ReclaimerLabs/Dronelight/documentation/39350_Reclaimer_Labs_LLC_16nov17.pdf

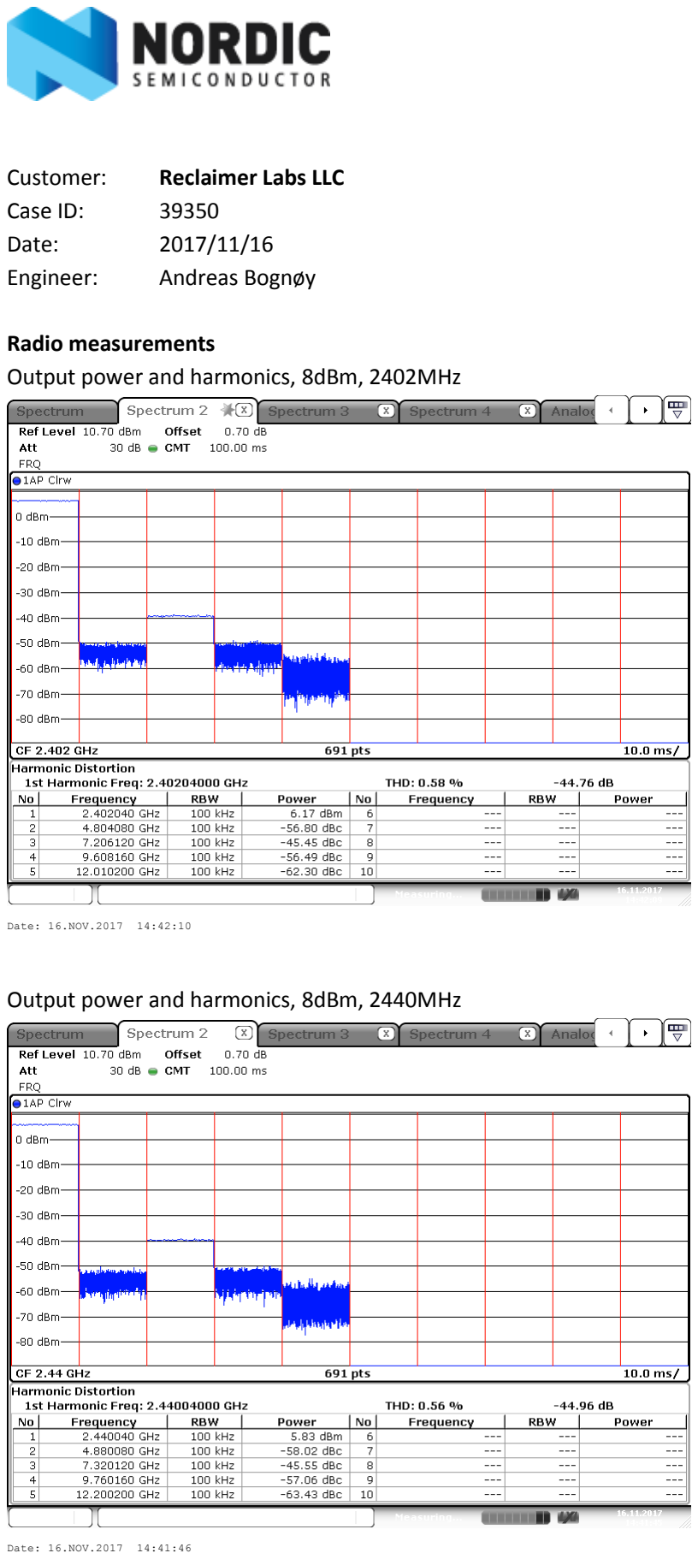
[picture p1: page 1]

Customer: | Reclaimer Labs LLC
Case ID: | 39350
Date: | 2017/11/16
Engineer: | Andreas Bognøy

Radio measurements
Output power and harmonics, 8dBm, 2402MHz

Output power and harmonics, 8dBm, 2440MHz

Date: 16.NOV.2017 | 14:42:10 Date: 16.NOV.2017 | 14:41:46

Output power and harmonics, 8dBm, 2480MHz

Output power and harmonics, 4dBm, 2402MHz

Date: 16.NOV.2017 | 14:42:48 Date: 16.NOV.2017 | 14:43:14

Output power and harmonics, 4dBm, 2440MHz

Output power and harmonics, 4dBm, 2480MHz

Date: 16.NOV.2017 | 14:43:44 Date: 16.NOV.2017 | 14:44:21

RX LO (channel 02-80)

Crystal accuracy

Date: 16.NOV.2017 | 14:48:50 Date: 16.NOV.2017 | 14:47:17

Antenna measurements
Impedance and SWR

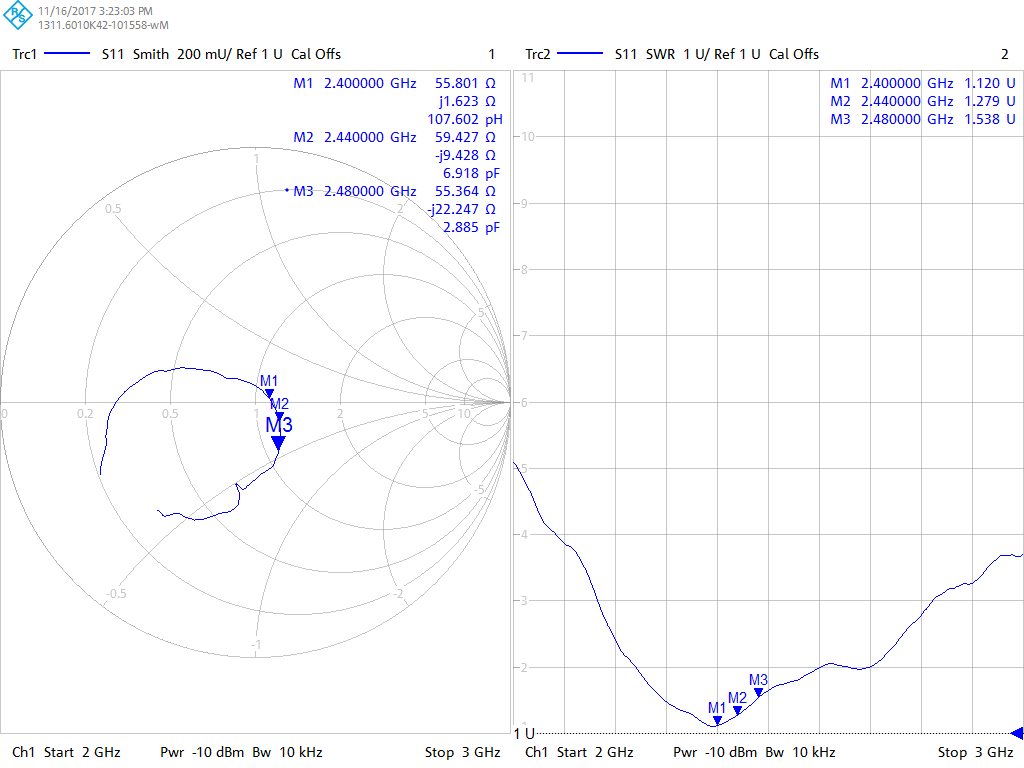
[picture p2: figure]

Cut antenna 1.5 mm
L3 = 0 Ohm/short
C_tune = 0.8 pF

Instruments:

Rohde&Schwarz | FSV13 | Cal date 2016-01 | Spectrum analyzer
Rohde&Schwarz | ZNB8 | Cal date 2016-01 | Vector Network analyzer
Agilent | E3646A | Cal date 2016-01 | Power supply
