ReclaimerLabs/Dronelight/electrical/dronelight_BOM.csv

Reference | Value | Footprint | Datasheet | Manufacturer | Manufacturer Part Number | Supplier 1 | Supplier 1 Part Number | Voltage | DisplayFootprint | TempCo | DNP
D1 | FSV8100V | Reclaimer_Labs:TO-277_3L_Diode |  | Fairchild-ON | FSV8100V | Digikey | FSV8100VCT-ND
L1 | 22uH | Reclaimer_Labs:Inductor_DR127 |  | Eaton | DR127-220-R | Digikey | 513-1044-1-ND
U1 | LT3755-2-MSE | Housings_SSOP:MSOP-16-1EP_3x4mm_Pitch0.5mm |  | Linear | LT3755EMSE-2#PBF | Digikey | LT3755EMSE-2#PBF-ND
Q1 | DMT6016 | Reclaimer_Labs:POWERDI5060-8 |  | Diodes Inc | DMT6016LPS-13
R8 | 0.0005R | Reclaimer_Labs:CST0612 |  | Bourns | CST0612-FC-R0005-E
C7 | 4.7uF | Capacitors_SMD:C_0805 |  | Samsung | CL21A475KOFNNNE
C8 | 1000pF | Capacitors_SMD:C_0603 |  | MacroFab | MF-CAP-0603-1nF
R9 | 28.7k | Resistors_SMD:R_0603 |  | Panasonic | ERJ-3EKF2872V | Digikey | P28.7KHCT-ND
C6 | 0.01uF | Capacitors_SMD:C_0603 |  | MacroFab | MF-CAP-0603-0.01uF
R7 | 100k | Resistors_SMD:R_0603 |  | MacroFab | MF-RES-0603-100K
RT1 | 100k | Resistors_SMD:R_0603 |  | Murata | NCP18WF104J03RB | Digikey | 490-2430-1-ND
R3 | 18k | Resistors_SMD:R_0603 |  | MacroFab | MF-RES-0603-18K
R6 | 100k | Resistors_SMD:R_0603 |  | MacroFab | MF-RES-0603-100K
R1 | 680k | Resistors_SMD:R_0603 |  | MacroFab | MF-RES-0603-680K
C3 | 10uF | Capacitors_SMD:C_1206 |  | Samsung | CL31A106MBHNNNE |  |  | 50V | 1206 | X5R
R10 | 10k | Resistors_SMD:R_0603 |  | MacroFab | MF-RES-0603-10K
R2 | 825k | Resistors_SMD:R_0603 |  | MacroFab | MF-RES-0603-825K
R4 | 39mR | Resistors_SMD:R_0603 |  | Panasonic | ERJ-3BWFR039V
R5 | 15k | Resistors_SMD:R_0603 |  | MacroFab | MF-RES-0603-15K
J2 | SAFETY | Socket_Strips:Socket_Strip_Straight_1x02_Pitch2.54mm |  | MacroFab | MF-CON-2.54mm-01x02
J1 | CONN_01X04 | Reclaimer_Labs:Header_04x01_2.5mm_RA |  | JST | S4B-EH(LF)(SN)
C2 | 10uF | Capacitors_SMD:C_1206 |  | Samsung | CL31A106MBHNNNE |  |  | 50V | 1206 | X5R
C1 | 10uF | Capacitors_SMD:C_1206 |  | Samsung | CL31A106MBHNNNE |  |  | 50V | 1206 | X5R
C4 | 4.7uF | Capacitors_SMD:C_1206 |  | Taiyo Yuden | HMK325BJ475KM-PE |  |  | 100V | 1210 | X5R
C5 | 4.7uF | Capacitors_SMD:C_1206 |  | Taiyo Yuden | HMK325BJ475KM-PE |  |  | 100V | 1210 | X5R
Q2 | DMT6016 | Reclaimer_Labs:POWERDI5060-8 |  | Diodes Inc | DMT6016LPS-13
C29 | 4.7uF | Capacitors_SMD:C_0805 |  | Samsung | CL21A475KOFNNNE
U2 | nrf52840 | Reclaimer_Labs:AQFN73 |  | Nordic | NRF52840-QIAA-T
J3 | ARM_Debug | Reclaimer_Labs:HEADER_SMT_02x05_1.27MM_POL |  | CNC Tech | 3220-10-0300-00
R11 | 100k | Resistors_SMD:R_0603 |  | MacroFab | MF-RES-0603-100K
Y1 | 32MHz | Reclaimer_Labs:Crystal_SMD_2016-4pin_2.0x1.6mm |  | Murata | XRCGB32M000F2P00R0
C12 | 8.2pF | Capacitors_SMD:C_0402 |  | MacroFab | MF-CAP-0402-8.2pF
C13 | 8.2pF | Capacitors_SMD:C_0402 |  | MacroFab | MF-CAP-0402-8.2pF
C10 | 0.8pF | Capacitors_SMD:C_0402 |  | Murata | GRM1555C2AR80BA01D
L2 | 3.3nH | Capacitors_SMD:C_0402 |  | TDK | MLG1005S3N3BT000
C11 | 0.5pF | Capacitors_SMD:C_0402 |  | Murata | GRM1555C1HR50BA01D
D2 | 1N4148 | Diodes_SMD:D_SOD-123 |  | MacroFab | MF-DIO-SOD123-1N4148
C15 | 1uF | Capacitors_SMD:C_0603 |  | MacroFab | MF-CAP-0603-1uF |  |  | 25V | 0603 | X7R
U3 | AP2204 | Reclaimer_Labs:SOT89-3 |  | Diodes Inc | AP2204R-3.3TRG1
C16 | 0.1uF | Capacitors_SMD:C_0402 |  | MacroFab | MF-CAP-0402-0.1uF |  |  |  | 0402
C20 | 1uF | Capacitors_SMD:C_0603 |  | MacroFab | MF-CAP-0603-1uF |  |  |  | 0603
C17 | 0.1uF | Capacitors_SMD:C_0402 |  | MacroFab | MF-CAP-0402-0.1uF |  |  |  | 0402
C18 | 0.1uF | Capacitors_SMD:C_0402 |  | MacroFab | MF-CAP-0402-0.1uF |  |  |  | 0402
C19 | 0.1uF | Capacitors_SMD:C_0402 |  | MacroFab | MF-CAP-0402-0.1uF |  |  |  | 0402
C23 | 0.1uF | Capacitors_SMD:C_0402 |  | MacroFab | MF-CAP-0402-0.1uF |  |  |  | 0402
C26 | 100pF | Capacitors_SMD:C_0402 |  | Murata | GRM1555C1H101JA01D |  |  |  | 0402
C27 | 1uF | Capacitors_SMD:C_0603 |  | MacroFab | MF-CAP-0603-1uF |  |  |  | 0603
C24 | DNP | Capacitors_SMD:C_0402 |  | MacroFab | MF-CAP-0402-0.1uF |  |  |  | 0402 |  | DNP
C25 | DNP | Capacitors_SMD:C_0402 |  | MacroFab | MF-CAP-0402-0.1uF |  |  |  | 0402 |  | DNP
A1 | Antenna | Reclaimer_Labs:2450AT18B100E |  | Johanson | 2450AT18B100E
L3 | 3.3nH | Capacitors_SMD:C_0402 |  | TDK | MLG1005S3N3BT000
C9 | 1.2pF | Capacitors_SMD:C_0402 |  | Johanson | 500R07S1R2BV4T
L4 | 2.7nH | Capacitors_SMD:C_0402 |  | Johanson | L-07C2N7SV6T
J6 | CONN_01X06 | Socket_Strips:Socket_Strip_Straight_1x06_Pitch2.54mm |  | MacroFab | MF-CON-2.54mm-01x06
C21 | 4.7uF | Capacitors_SMD:C_0805 |  | Samsung | CL21A475KOFNNNE |  |  |  | 0805
C14 | 4.7uF | Capacitors_SMD:C_0805 |  | Samsung | CL21A475KOFNNNE |  |  |  | 0805
C22 | 4.7uF | Capacitors_SMD:C_0805 |  | Samsung | CL21A475KOFNNNE |  |  |  | 0805
RT2 | 100k | Resistors_SMD:R_0603 |  | Murata | NCP18WF104J03RB | Digikey | 490-2430-1-ND
R15 | 18k | Resistors_SMD:R_0603 |  | MacroFab | MF-RES-0603-18K
R16 | 750k | Resistors_SMD:R_0603 |  | MacroFab | MF-RES-0603-750K
R17 | 100k | Resistors_SMD:R_0603 |  | MacroFab | MF-RES-0603-100K
J7 | CONN_02X06 | Socket_Strips:Socket_Strip_Straight_2x06_Pitch2.54mm
C28 | DNP | Capacitors_SMD:C_0603 |  | MacroFab | MF-CAP-0603-1uF |  |  |  | 0603 |  | DNP
J4 | XT30 | Reclaimer_Labs:XT30
J5 | USB_OTG | Reclaimer_Labs:USB_Micro-B_10118194-0001LF |  | MacroFab | MF-CON-MICROUSB-RIGHT
X1 | MTHOLE | Reclaimer_Labs:MountingHole_3.5mm_Pad_Via
R12 | 1k | Resistors_SMD:R_0603 |  | MacroFab | MF-RES-0603-1K
D3 | RGB LED 3228 SMD PLCC-4 | Reclaimer_Labs:PLCC4 |  | MacroFab | MF-LED-3228-RGB
R13 | 1k | Resistors_SMD:R_0603 |  | MacroFab | MF-RES-0603-1K
R14 | 1k | Resistors_SMD:R_0603 |  | MacroFab | MF-RES-0603-1K
X2 | MTHOLE | Reclaimer_Labs:MountingHole_3.5mm_Pad_Via
X3 | MTHOLE | Reclaimer_Labs:MountingHole_3.5mm_Pad_Via
X4 | MTHOLE | Reclaimer_Labs:MountingHole_3.5mm_Pad_Via
X5 | HEATSINK | Reclaimer_Labs:573100D00010G |  | Aavid Thermalloy | 573100D00010G
X6 | HEATSINK | Reclaimer_Labs:573100D00010G |  | Aavid Thermalloy | 573100D00010G
X7 | HEATSINK | Reclaimer_Labs:573100D00010G |  | Aavid Thermalloy | 573100D00010G
Q3 | Photo_Trans | Reclaimer_Labs:Photo_Trans_ALS-PT19-315C |  | Everlight | ALS-PT19-315C/L177/TR8
R18 | 10k | Resistors_SMD:R_0603 |  | MacroFab | MF-RES-0603-10K
U5 | LPS22HB | Reclaimer_Labs:LGA10R50P2X3_200X200X80 |  | ST | LPS22HBTR
C30 | 0.1uF | Capacitors_SMD:C_0402 |  | MacroFab | MF-CAP-0402-0.1uF |  |  |  | 0402
U4 | SPK0415HM4H-B | Reclaimer_Labs:SPK0415HM4H-8 |  | Knowles | SPK0415HM4H-B-7
C31 | 0.1uF | Capacitors_SMD:C_0402 |  | MacroFab | MF-CAP-0402-0.1uF |  |  |  | 0402
