ReclaimerLabs/Dronelight/electrical/dronelight_Rev2_schematic.pdf

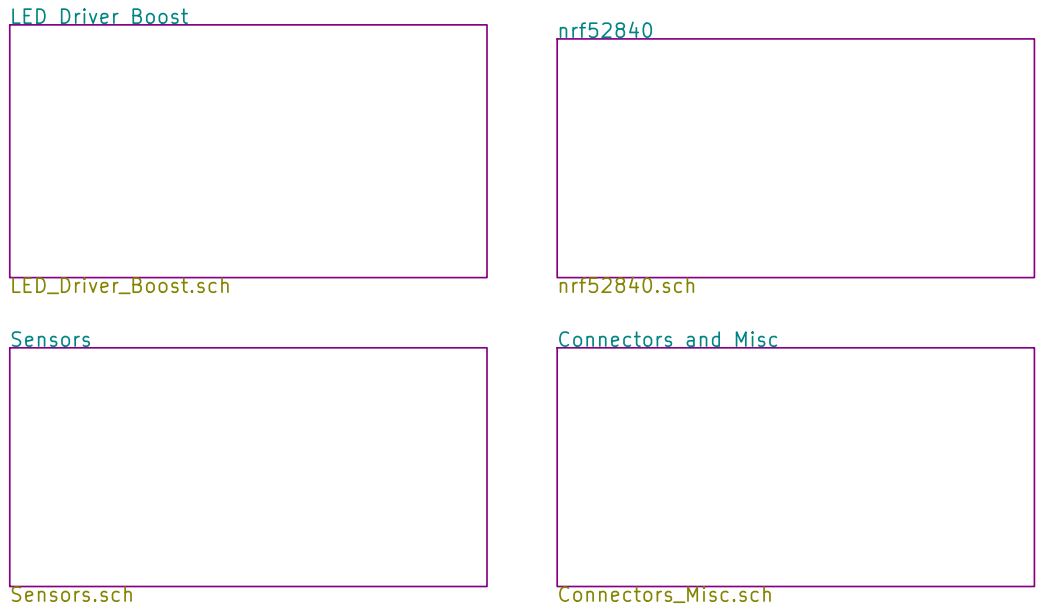
[picture p3: page 1]

LED Driver Boost LED_Driver_Boost.sch

nrf52840.sch Connectors and Misc Connectors_Misc.sch Sensors Sensors.sch

File: dronelight.sch Sheet: / Reclaimer Labs LLC

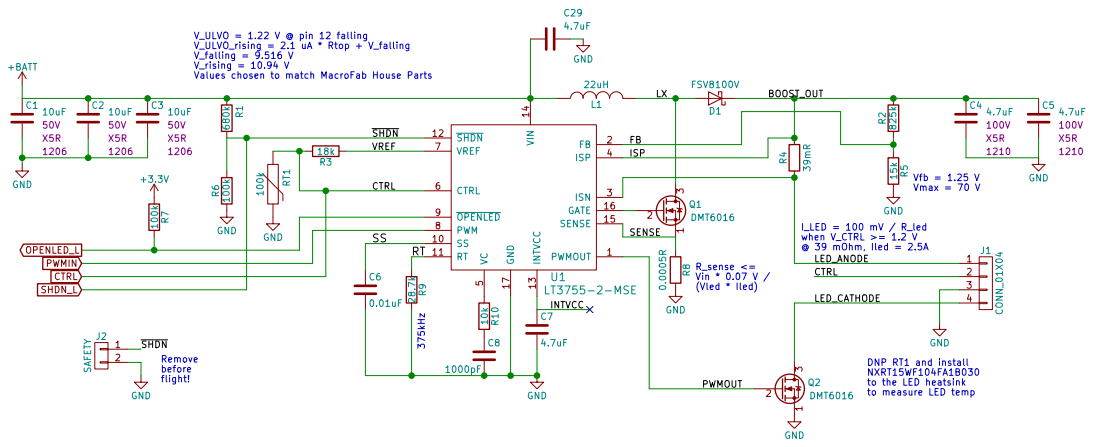
[picture p4: page 2]

5 CTRL 6 VREF 7 PWM 8 OPENLED 9 SS 10 RT 11 SHDN 12 INTVCC 13 VIN 14 SENSE 15 GATE 16 GND 17U1

3 Q1DMT6016 R8 0.0005R GND GND GND GND

DNP RT1 and install NXRT15WF104FA1B030
to the LED heatsink
to measure LED temp

File: LED_Driver_Boost.sch Sheet: /LED Driver Boost/ Reclaimer Labs LLC

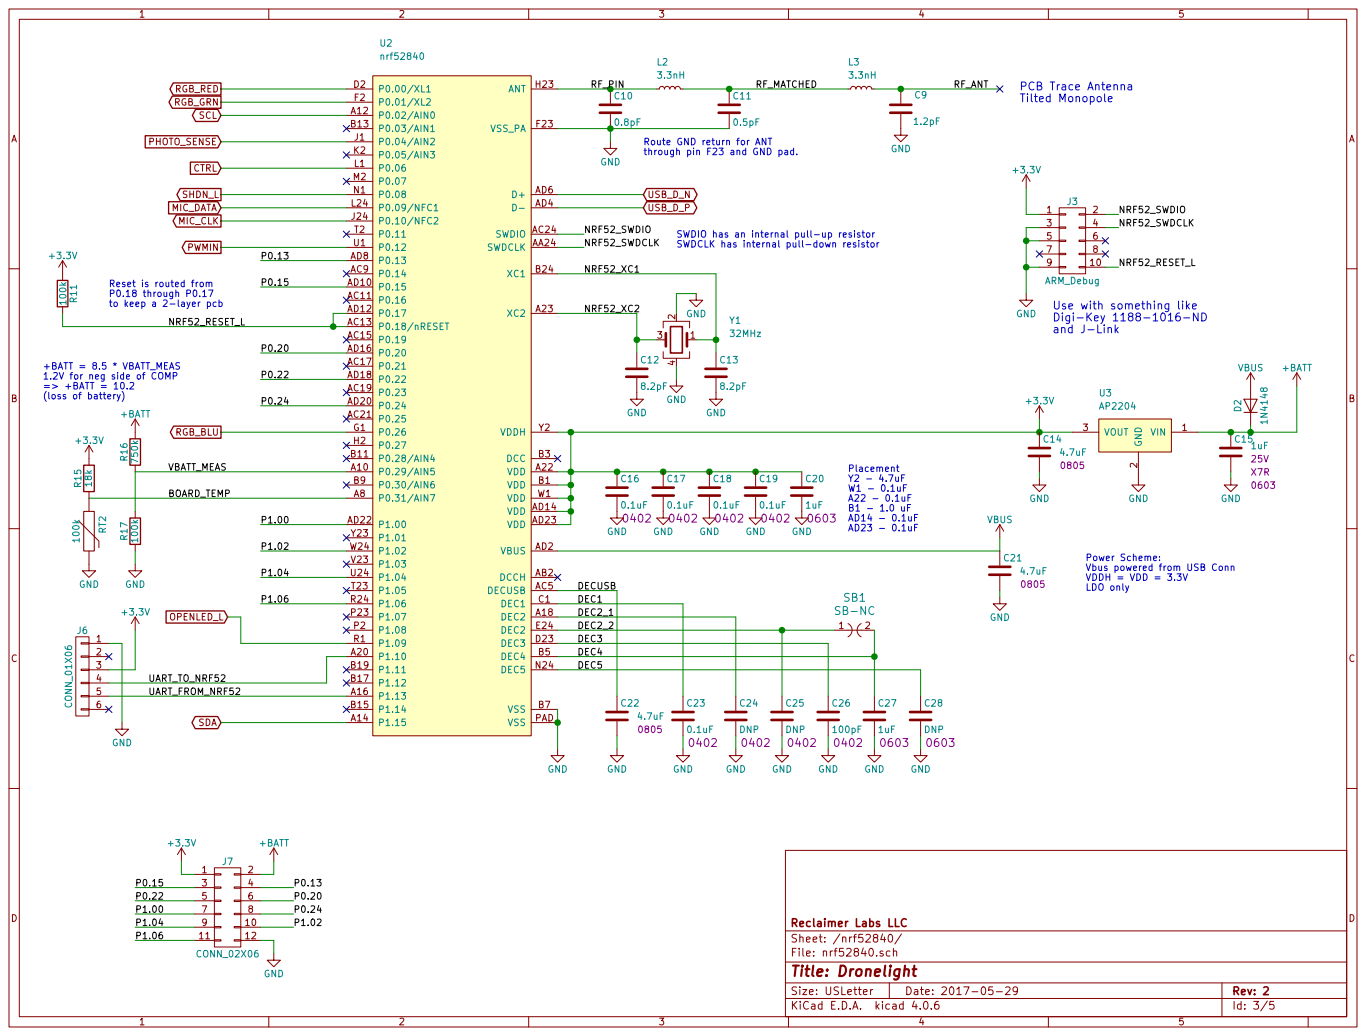
[picture p5: page 3]

Route GND return for ANT

NRF52_SWDCLK Use with something like

SWDCLK has internal pull-down resistor 100k R11 +3.3V

to keep a 2-layer pcb

+BATT = 8.5 * VBATT_MEAS
1.2V for neg side of COMP
=> +BATT = 10.2

Id: 3/5 Title: Dronelight File: nrf52840.sch Sheet: /nrf52840/ Reclaimer Labs LLC

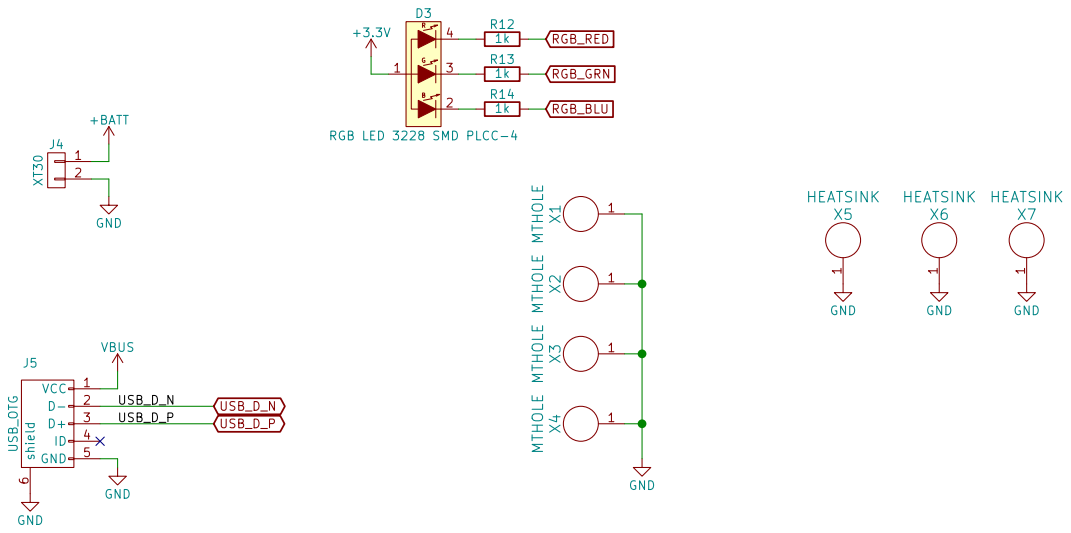
[picture p6: page 4]

4 D3 RGB LED 3228 SMD PLCC-4R13

File: Connectors_Misc.sch Sheet: /Connectors and Misc/ Reclaimer Labs LLC

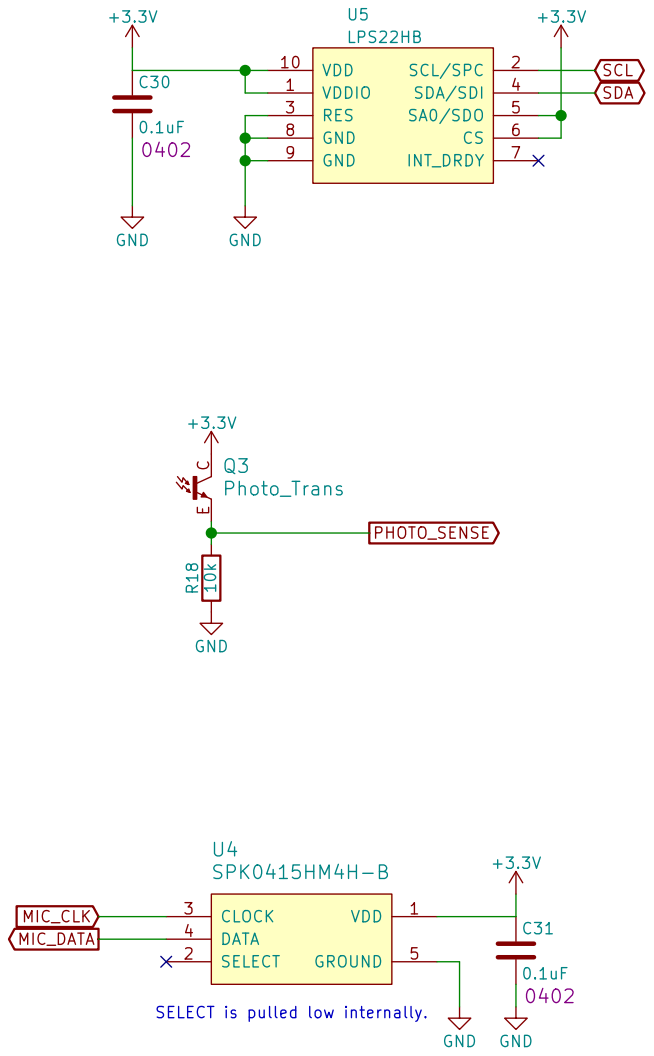
[picture p7: page 5]

SELECT is pulled low internally. MIC_CLK MIC_DATA

Id: 5/5 Title: Dronelight File: Sensors.sch Sheet: /Sensors/ Reclaimer Labs LLC
