ReclaimerLabs/Dronelight/electrical/gerber/dronelight-F.SilkS.pdf

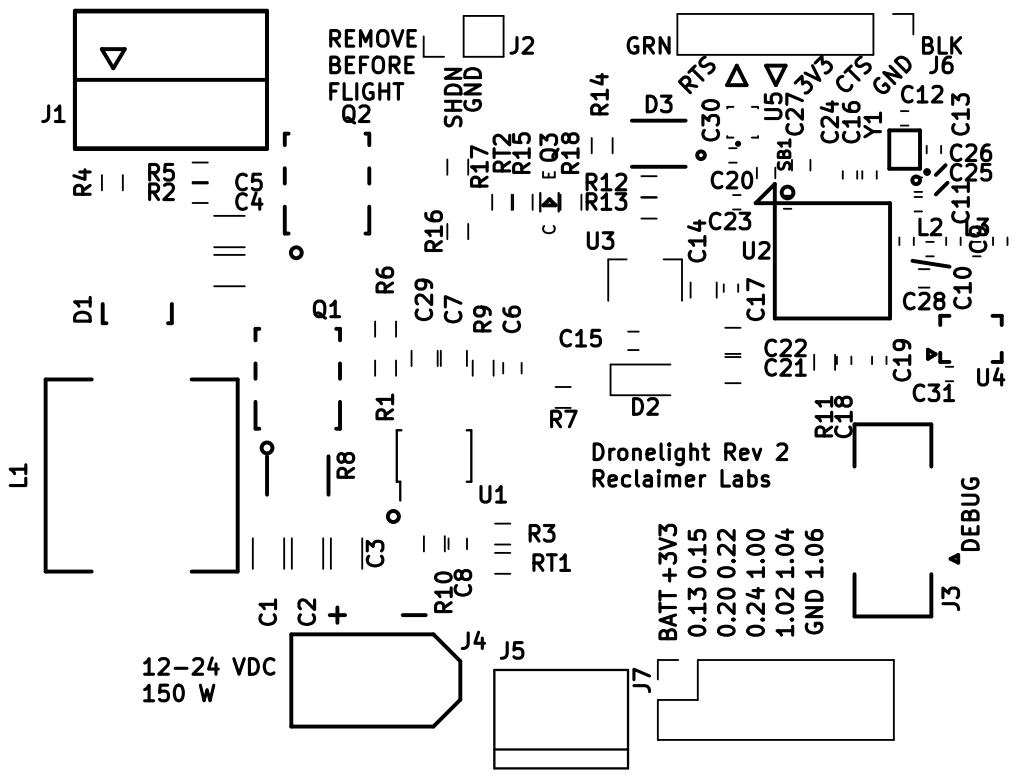
[picture p8: page 1]

Dronelight Rev 2 Reclaimer Labs REMOVE BEFORE

C E GRN BLK DEBUG 1.06 GND 1.04 1.02 +3V3 BATT 0.24 1.00 0.20 0.22 0.13 0.15
