ReclaimerLabs/Dronelight/electrical/gerber/dronelight-B.Cu.pdf

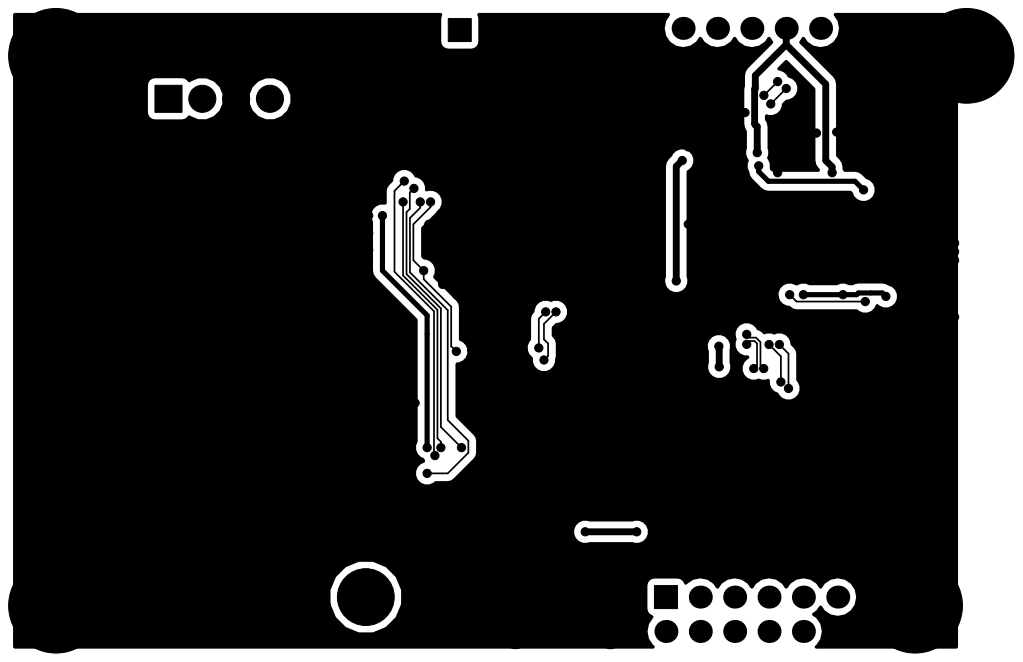
[picture p9: page 1]
