ReclaimerLabs/Dronelight/electrical/gerber/dronelight-B.Mask.pdf

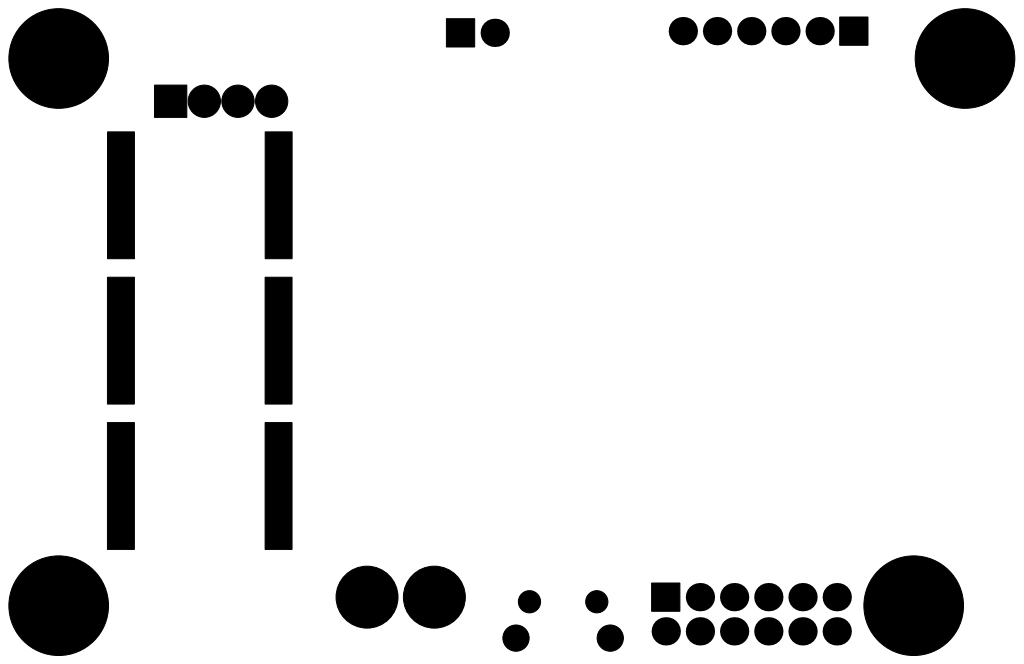
[picture p10: page 1]
