ReclaimerLabs/Dronelight/electrical/gerber/dronelight-Dwgs.User.pdf

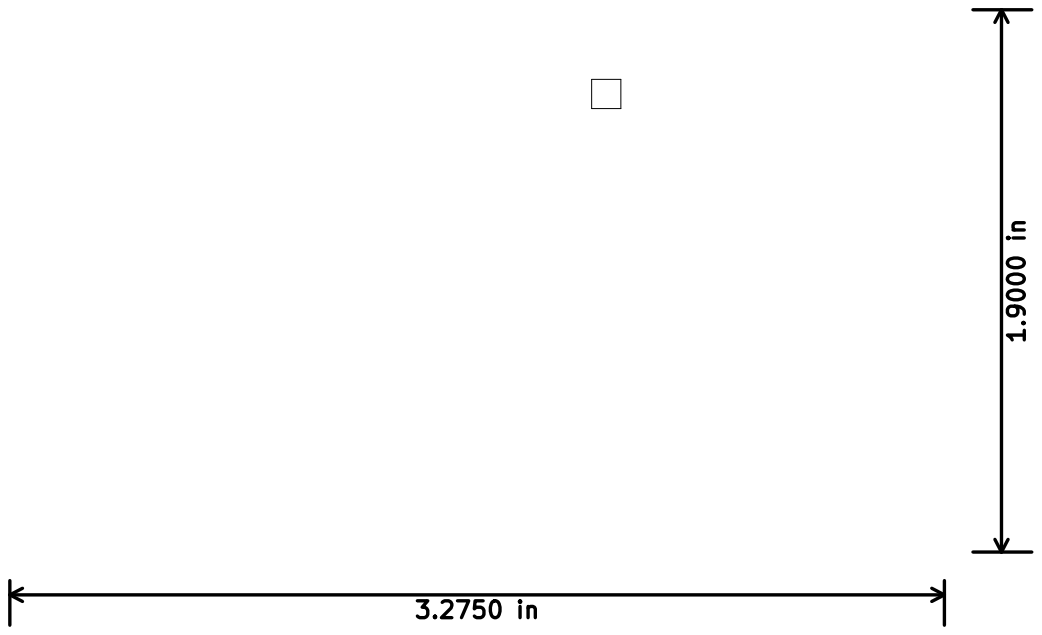
[picture p11: page 1]
