ReclaimerLabs/Dronelight/electrical/gerber/dronelight-F.Cu.pdf

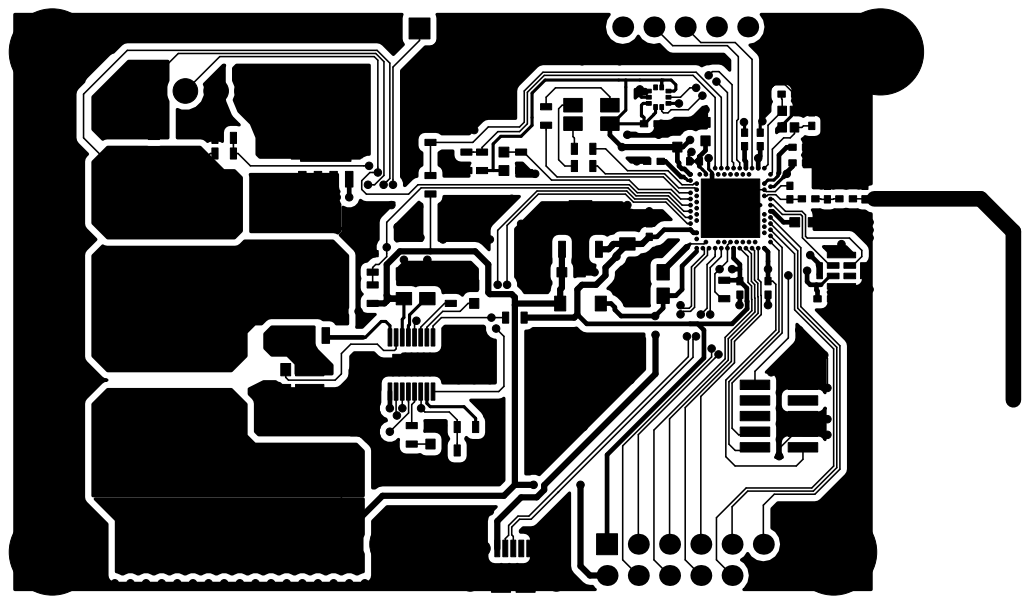
[picture p12: page 1]
