ReclaimerLabs/Dronelight/electrical/gerber/dronelight-F.Mask.pdf

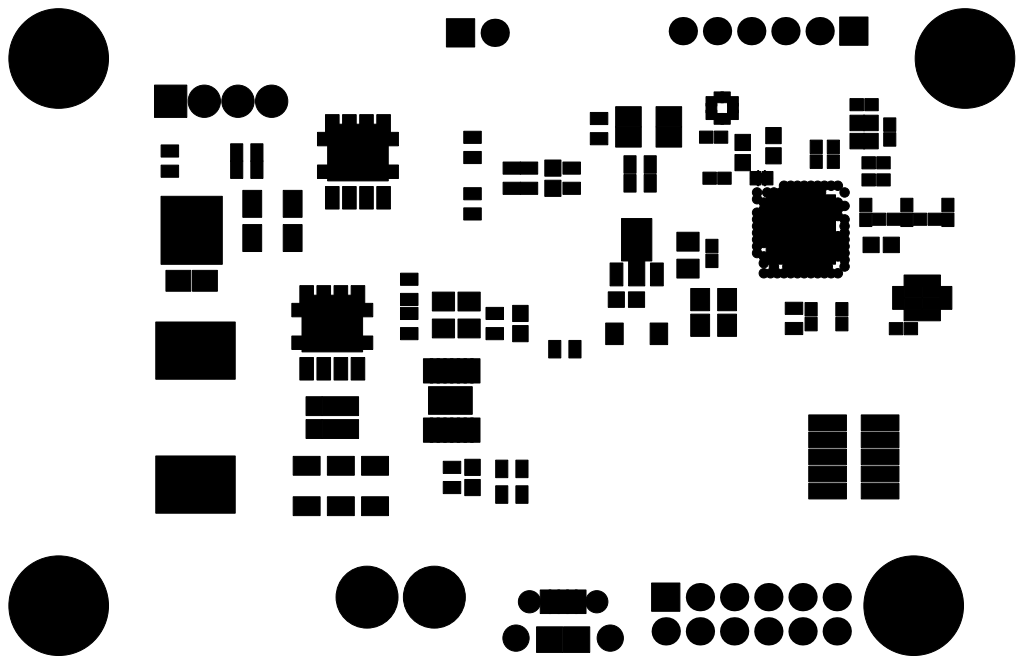
[picture p13: page 1]
