ReclaimerLabs/Dronelight/electrical/gerber/dronelight-F.Paste.pdf

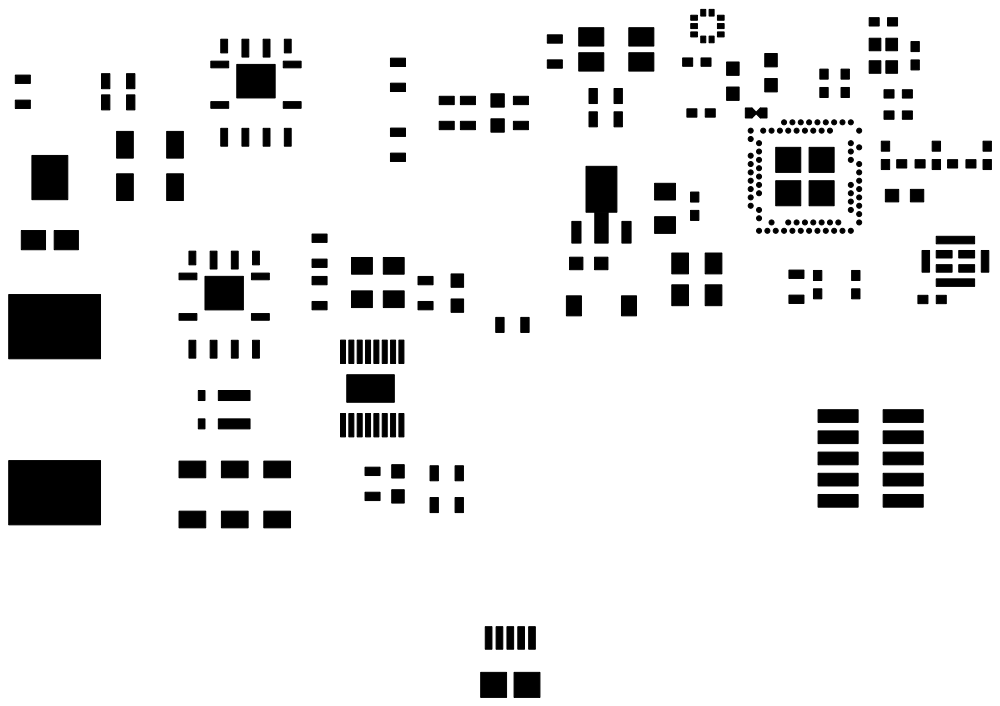
[picture p14: page 1]
