ReclaimerLabs/Dronelight/electrical/dronelight.kicad_pcb

## KiCad design electrical/dronelight.kicad_pcb (2017-11-29)

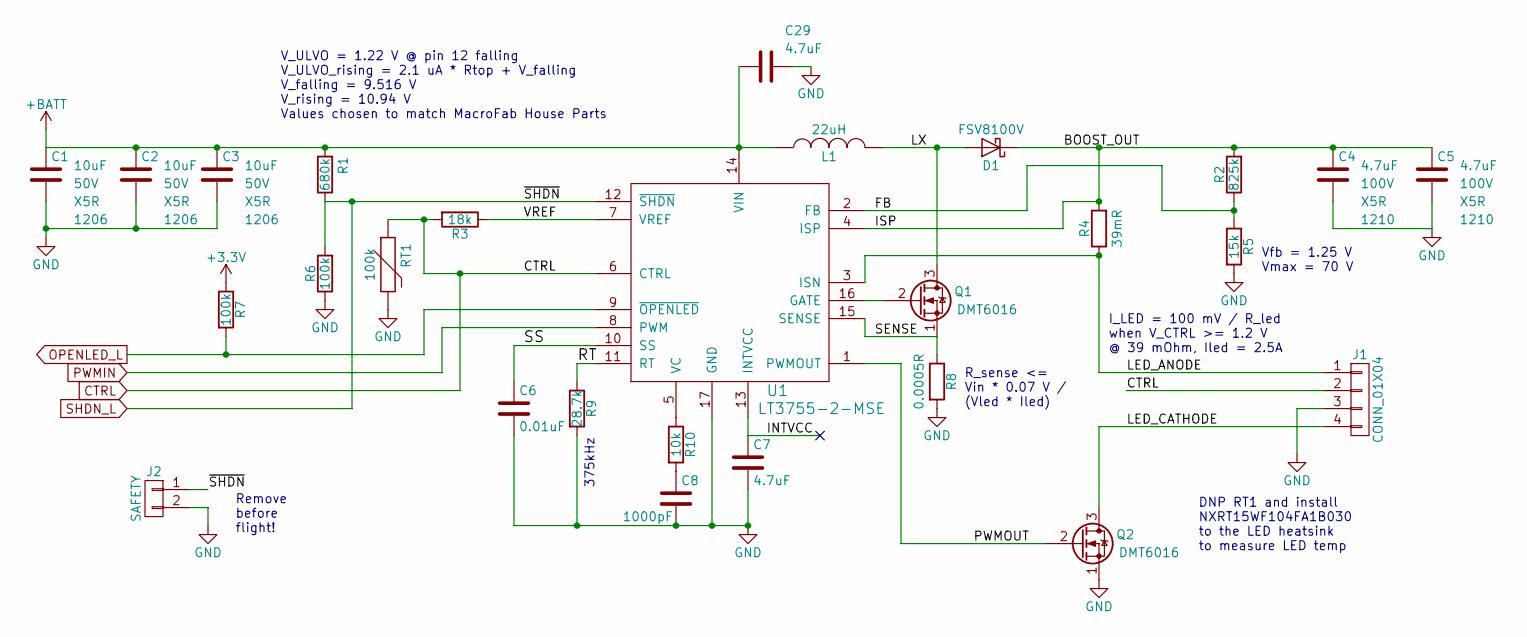
[picture p15: schematic LED_Driver_Boost.sch, Dronelight]

Parts:
C1, C2, C3: 10uF; C_1206; Voltage 50V; Manufacturer Part Number CL31A106MBHNNNE
C4, C5: 4.7uF; C_1206; Voltage 100V; Manufacturer Part Number HMK325BJ475KM-PE
C6: 0.01uF; C_0603; Manufacturer Part Number MF-CAP-0603-0.01uF
C7, C29: 4.7uF; C_0805; Manufacturer Part Number CL21A475KOFNNNE
C8: 1000pF; C_0603; Manufacturer Part Number MF-CAP-0603-1nF
D1: FSV8100V; TO-277_3L_Diode; Manufacturer Part Number FSV8100V
J1: CONN_01X04; Header_04x01_2.5mm_RA; Manufacturer Part Number S4B-EH(LF)(SN)
J2: SAFETY; Socket_Strip_Straight_1x02_Pitch2.54mm; Manufacturer Part Number MF-CON-2.54mm-01x02
L1: 22uH; Inductor_DR127; Manufacturer Part Number DR127-220-R
Q1, Q2: DMT6016; POWERDI5060-8; Manufacturer Part Number DMT6016LPS-13
R1: 680k; R_0603; Manufacturer Part Number MF-RES-0603-680K
R2: 825k; R_0603; Manufacturer Part Number MF-RES-0603-825K
R3: 18k; R_0603; Manufacturer Part Number MF-RES-0603-18K
R4: 39mR; R_0603; Manufacturer Part Number ERJ-3BWFR039V
R5: 15k; R_0603; Manufacturer Part Number MF-RES-0603-15K
R6, R7: 100k; R_0603; Manufacturer Part Number MF-RES-0603-100K
R8: 0.0005R; CST0612; Manufacturer Part Number CST0612-FC-R0005-E
R9: 28.7k; R_0603; Manufacturer Part Number ERJ-3EKF2872V
R10: 10k; R_0603; Manufacturer Part Number MF-RES-0603-10K
RT1: 100k; R_0603; Manufacturer Part Number NCP18WF104J03RB
U1: LT3755-2-MSE; MSOP-16-1EP_3x4mm_Pitch0.5mm; Manufacturer Part Number LT3755EMSE-2#PBF

Connections:
+3V3: R7.1; also elsewhere on the board
+BATT: C1.1, C2.1, C3.1, C29.2, L1.1, R1.2, U1.14 (VIN); also elsewhere on the board
/LED Driver Boost/BOOST_OUT: C4.1, C5.1, D1.1 (K), R2.2, R4.2, U1.4 (ISP)
/LED Driver Boost/FB: R2.1, R5.1, U1.2 (FB)
/LED Driver Boost/INTVCC: C7.1, U1.13 (INTVCC)
/LED Driver Boost/LED_ANODE: J1.1, R4.1, U1.3 (ISN)
/LED Driver Boost/LED_CATHODE: J1.4, Q2.3 (D)
/LED Driver Boost/LX: D1.2 (A), L1.2, Q1.3 (D)
/LED Driver Boost/PWMOUT: Q2.2 (G), U1.1 (PWMOUT)
/LED Driver Boost/RT: R9.1, U1.11 (RT)
/LED Driver Boost/SENSE: Q1.1 (S), R8.1, U1.15 (SENSE)
/LED Driver Boost/SS: C6.1, U1.10 (SS)
/LED Driver Boost/VREF: R3.1, U1.7 (VREF)
CTRL: J1.2, R3.2, RT1.1, U1.6 (CTRL); also elsewhere on the board
GND: C1.2, C2.2, C3.2, C4.2, C5.2, C6.2, C7.2, C8.2, C29.1, J1.3, J2.2, Q2.1 (S), R5.2, R6.1, R8.2, R9.2, RT1.2, U1.17 (GND); also elsewhere on the board
unnamed: C8.1, R10.2
unnamed: Q1.2 (G), U1.16 (GATE)
unnamed: R10.1, U1.5 (VC)
OPENLED_L: R7.2, U1.9 (~OPENLED); also elsewhere on the board
PWMIN: U1.8 (PWM); also elsewhere on the board
SHDN_L: J2.1, R1.1, R6.2, U1.12 (~SHDN); also elsewhere on the board

Notes on the sheet:
375kHz
Vfb = 1.25 V Vmax = 70 V
Remove before flight!
V_ULVO = 1.22 V @ pin 12 falling V_ULVO_rising = 2.1 uA * Rtop + V_falling V_falling = 9.516 V V_rising = 10.94 V Values chosen to match MacroFab House Parts
DNP RT1 and install NXRT15WF104FA1B030 to the LED heatsink to measure LED temp
I_LED = 100 mV / R_led when V_CTRL >= 1.2 V @ 39 mOhm, Iled = 2.5A
R_sense <= Vin * 0.07 V / (Vled * Iled)

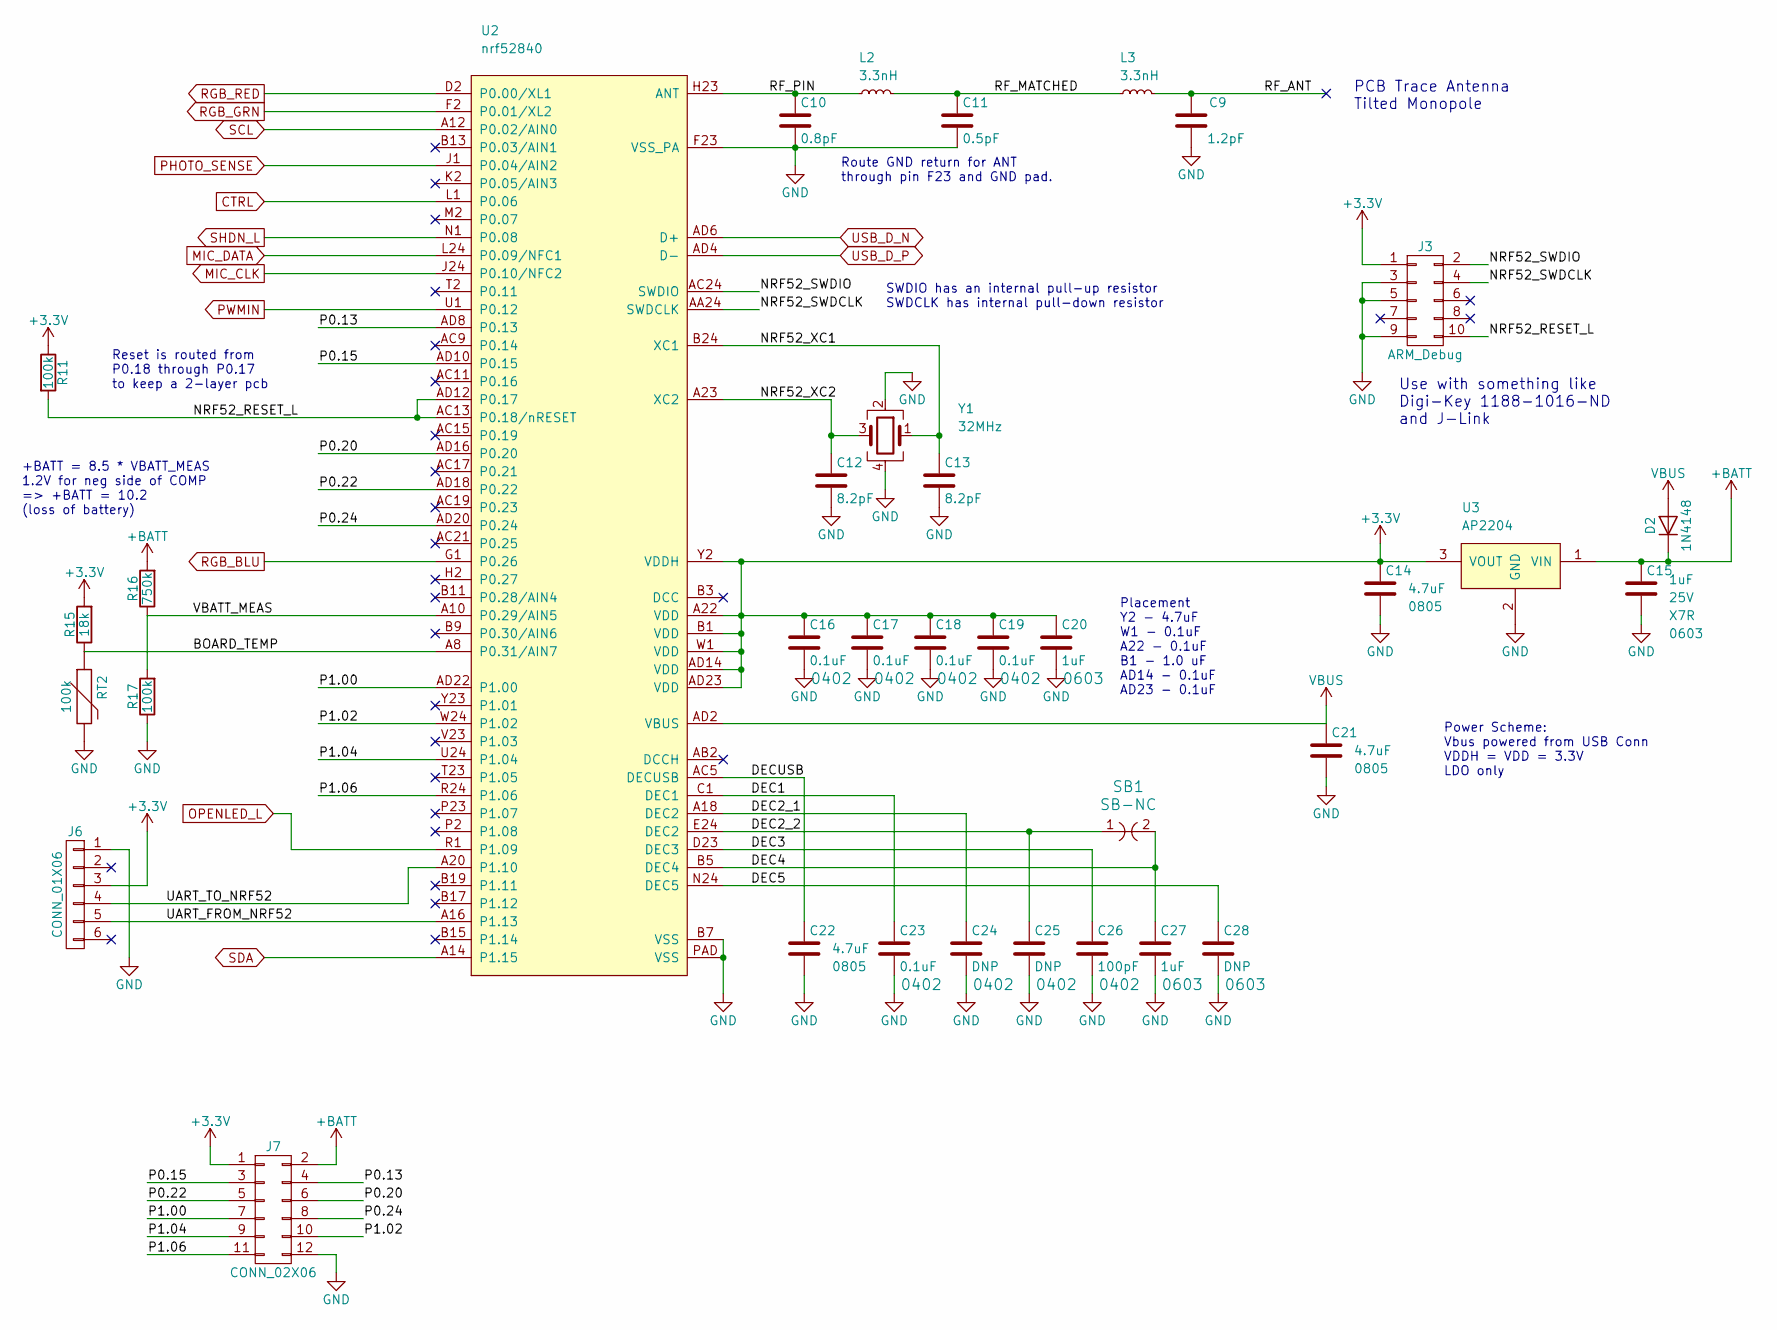
[picture p16: schematic nrf52840.sch, Dronelight]

Parts:
C9: 1.2pF; C_0402; Manufacturer Part Number 500R07S1R2BV4T
C10: 0.8pF; C_0402; Manufacturer Part Number GRM1555C2AR80BA01D
C11: 0.5pF; C_0402; Manufacturer Part Number GRM1555C1HR50BA01D
C12, C13: 8.2pF; C_0402; Manufacturer Part Number MF-CAP-0402-8.2pF
C14, C21, C22: 4.7uF; C_0805; Manufacturer Part Number CL21A475KOFNNNE
C15: 1uF; C_0603; Voltage 25V; Manufacturer Part Number MF-CAP-0603-1uF
C16, C17, C18, C19, C23: 0.1uF; C_0402; Manufacturer Part Number MF-CAP-0402-0.1uF
C20, C27: 1uF; C_0603; Manufacturer Part Number MF-CAP-0603-1uF
C24, C25: DNP; C_0402; Manufacturer Part Number MF-CAP-0402-0.1uF
C26: 100pF; C_0402; Manufacturer Part Number GRM1555C1H101JA01D
C28: DNP; C_0603; Manufacturer Part Number MF-CAP-0603-1uF
D2: 1N4148; D_SOD-123; Manufacturer Part Number MF-DIO-SOD123-1N4148
J3: ARM_Debug; HEADER_SMT_02x05_1.27MM_POL; Manufacturer Part Number 3220-10-0300-00
J6: CONN_01X06; Socket_Strip_Straight_1x06_Pitch2.54mm; Manufacturer Part Number MF-CON-2.54mm-01x06
J7: CONN_02X06; Socket_Strip_Straight_2x06_Pitch2.54mm
L2, L3: 3.3nH; C_0402; Manufacturer Part Number MLG1005S3N3BT000
R11, R17: 100k; R_0603; Manufacturer Part Number MF-RES-0603-100K
R15: 18k; R_0603; Manufacturer Part Number MF-RES-0603-18K
R16: 750k; R_0603; Manufacturer Part Number MF-RES-0603-750K
RT2: 100k; R_0603; Manufacturer Part Number NCP18WF104J03RB
SB1: SB-NC
U2: nrf52840; AQFN73; Manufacturer Part Number NRF52840-QIAA-T
U3: AP2204; SOT89-3; Manufacturer Part Number AP2204R-3.3TRG1
Y1: 32MHz; Crystal_SMD_2016-4pin_2.0x1.6mm; Manufacturer Part Number XRCGB32M000F2P00R0

Connections:
+3V3: C14.1, C16.1, C17.1, C18.1, C19.1, C20.1, J3.1, J6.3, J7.1, R11.1, R15.2, U2.A22 (VDD), U2.AD14 (VDD), U2.AD23 (VDD), U2.B1 (VDD), U2.W1 (VDD), U2.Y2 (VDDH), U3.3 (VOUT); also elsewhere on the board
+BATT: C15.1, D2.1 (K), J7.2, R16.2, U3.1 (VIN); also elsewhere on the board
/nrf52840/BOARD_TEMP: R15.1, RT2.1, U2.A8 (P0.31/AIN7)
/nrf52840/DEC1: C23.1, U2.C1 (DEC1)
/nrf52840/DEC2_1: C24.1, U2.A18 (DEC2)
/nrf52840/DEC2_2: C25.1, SB1.1, U2.E24 (DEC2)
/nrf52840/DEC3: C26.1, U2.D23 (DEC3)
/nrf52840/DEC4: C27.1, SB1.2, U2.B5 (DEC4)
/nrf52840/DEC5: C28.1, U2.N24 (DEC5)
/nrf52840/DECUSB: C22.1, U2.AC5 (DECUSB)
/nrf52840/NRF52_RESET_L: J3.10, R11.2, U2.AC13 (P0.18/nRESET), U2.AD12 (P0.17)
/nrf52840/NRF52_SWDCLK: J3.4, U2.AA24 (SWDCLK)
/nrf52840/NRF52_SWDIO: J3.2, U2.AC24 (SWDIO)
/nrf52840/NRF52_XC1: C13.1, U2.B24 (XC1), Y1.1
/nrf52840/NRF52_XC2: C12.1, U2.A23 (XC2), Y1.3
/nrf52840/P0.13: J7.4, U2.AD8 (P0.13)
/nrf52840/P0.15: J7.3, U2.AD10 (P0.15)
/nrf52840/P0.20: J7.6, U2.AD16 (P0.20)
/nrf52840/P0.22: J7.5, U2.AD18 (P0.22)
/nrf52840/P0.24: J7.8, U2.AD20 (P0.24)
/nrf52840/P1.00: J7.7, U2.AD22 (P1.00)
/nrf52840/P1.02: J7.10, U2.W24 (P1.02)
/nrf52840/P1.04: J7.9, U2.U24 (P1.04)
/nrf52840/P1.06: J7.11, U2.R24 (P1.06)
/nrf52840/RF_ANT: C9.2, L3.2
/nrf52840/RF_MATCHED: C11.1, L2.2, L3.1
/nrf52840/RF_PIN: C10.1, L2.1, U2.H23 (ANT)
/nrf52840/UART_FROM_NRF52: J6.5, U2.A16 (P1.13)
/nrf52840/UART_TO_NRF52: J6.4, U2.A20 (P1.10)
/nrf52840/VBATT_MEAS: R16.1, R17.2, U2.A10 (P0.29/AIN5)
CTRL: U2.L1 (P0.06); also elsewhere on the board
GND: C9.1, C10.2, C11.2, C12.2, C13.2, C14.2, C15.2, C16.2, C17.2, C18.2, C19.2, C20.2, C21.2, C22.2, C23.2, C24.2, C25.2, C26.2, C27.2, C28.2, J3.3, J3.5, J3.9, J6.1, J7.12, R17.1, RT2.2, U2.B7 (VSS), U2.F23 (VSS_PA), U2.PAD (VSS), U3.2 (GND), Y1.2, Y1.4; also elsewhere on the board
MIC_CLK: U2.J24 (P0.10/NFC2); also elsewhere on the board
MIC_DATA: U2.L24 (P0.09/NFC1); also elsewhere on the board
OPENLED_L: U2.R1 (P1.09); also elsewhere on the board
PHOTO_SENSE: U2.J1 (P0.04/AIN2); also elsewhere on the board
PWMIN: U2.U1 (P0.12); also elsewhere on the board
RGB_BLU: U2.G1 (P0.26); also elsewhere on the board
RGB_GRN: U2.F2 (P0.01/XL2); also elsewhere on the board
RGB_RED: U2.D2 (P0.00/XL1); also elsewhere on the board
SCL: U2.A12 (P0.02/AIN0); also elsewhere on the board
SDA: U2.A14 (P1.15); also elsewhere on the board
SHDN_L: U2.N1 (P0.08); also elsewhere on the board
USB_D_N: U2.AD6 (D+); also elsewhere on the board
USB_D_P: U2.AD4 (D-); also elsewhere on the board
VBUS: C21.1, D2.2 (A), U2.AD2 (VBUS); also elsewhere on the board

Notes on the sheet:
Use with something like Digi-Key 1188-1016-ND and J-Link
SWDIO has an internal pull-up resistor SWDCLK has internal pull-down resistor
Route GND return for ANT through pin F23 and GND pad.
Placement Y2 - 4.7uF W1 - 0.1uF A22 - 0.1uF B1 - 1.0 uF AD14 - 0.1uF AD23 - 0.1uF
Power Scheme: Vbus powered from USB Conn VDDH = VDD = 3.3V LDO only
+BATT = 8.5 * VBATT_MEAS 1.2V for neg side of COMP => +BATT = 10.2 (loss of battery)
Reset is routed from P0.18 through P0.17 to keep a 2-layer pcb
PCB Trace Antenna Tilted Monopole

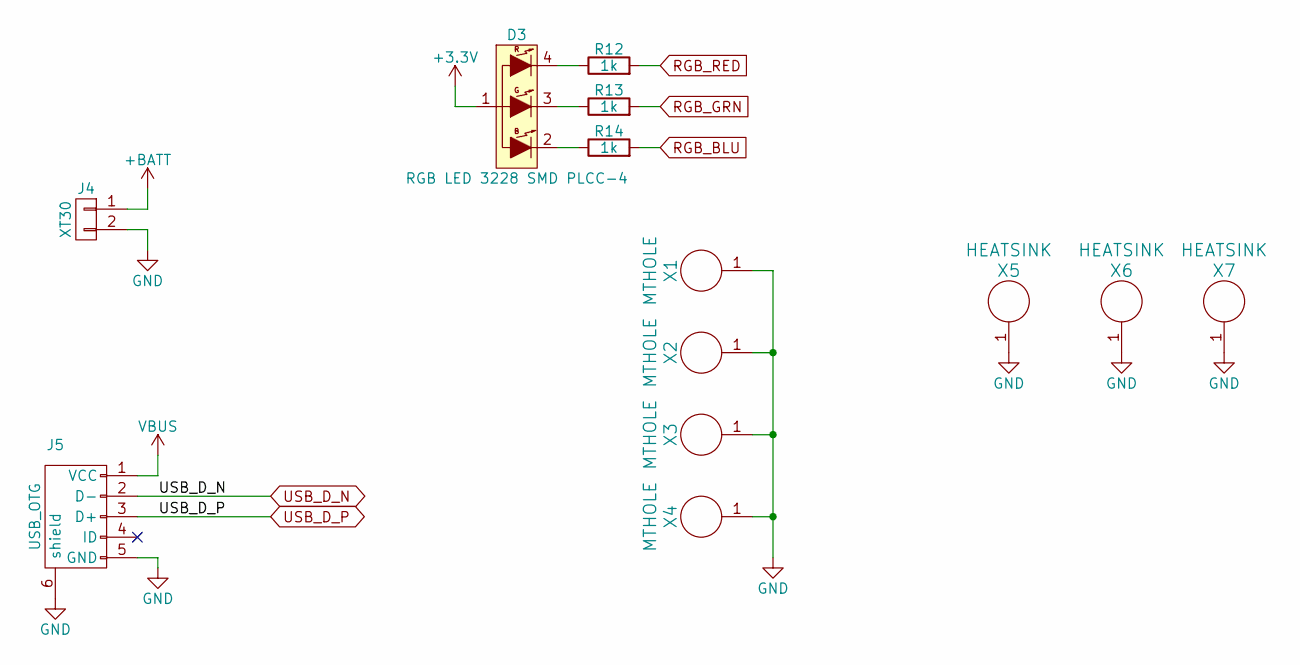
[picture p17: schematic Connectors_Misc.sch, Dronelight]

Parts:
D3: RGB LED 3228 SMD PLCC-4; PLCC4; Manufacturer Part Number MF-LED-3228-RGB
J4: XT30
J5: USB_OTG; USB_Micro-B_10118194-0001LF; Manufacturer Part Number MF-CON-MICROUSB-RIGHT
R12, R13, R14: 1k; R_0603; Manufacturer Part Number MF-RES-0603-1K
X1, X2, X3, X4: MTHOLE; MountingHole_3.5mm_Pad_Via
X5, X6, X7: HEATSINK; 573100D00010G; Manufacturer Part Number 573100D00010G

Connections:
+3V3: D3.1; also elsewhere on the board
+BATT: J4.1; also elsewhere on the board
GND: J4.2, J5.5 (GND), J5.6 (shield), X1.1, X2.1, X3.1, X4.1, X5.1, X6.1, X7.1; also elsewhere on the board
unnamed: D3.2 (B), R14.1
unnamed: D3.3 (G), R13.1
unnamed: D3.4 (R), R12.1
RGB_BLU: R14.2; also elsewhere on the board
RGB_GRN: R13.2; also elsewhere on the board
RGB_RED: R12.2; also elsewhere on the board
USB_D_N: J5.2 (D-); also elsewhere on the board
USB_D_P: J5.3 (D+); also elsewhere on the board
VBUS: J5.1 (VCC); also elsewhere on the board

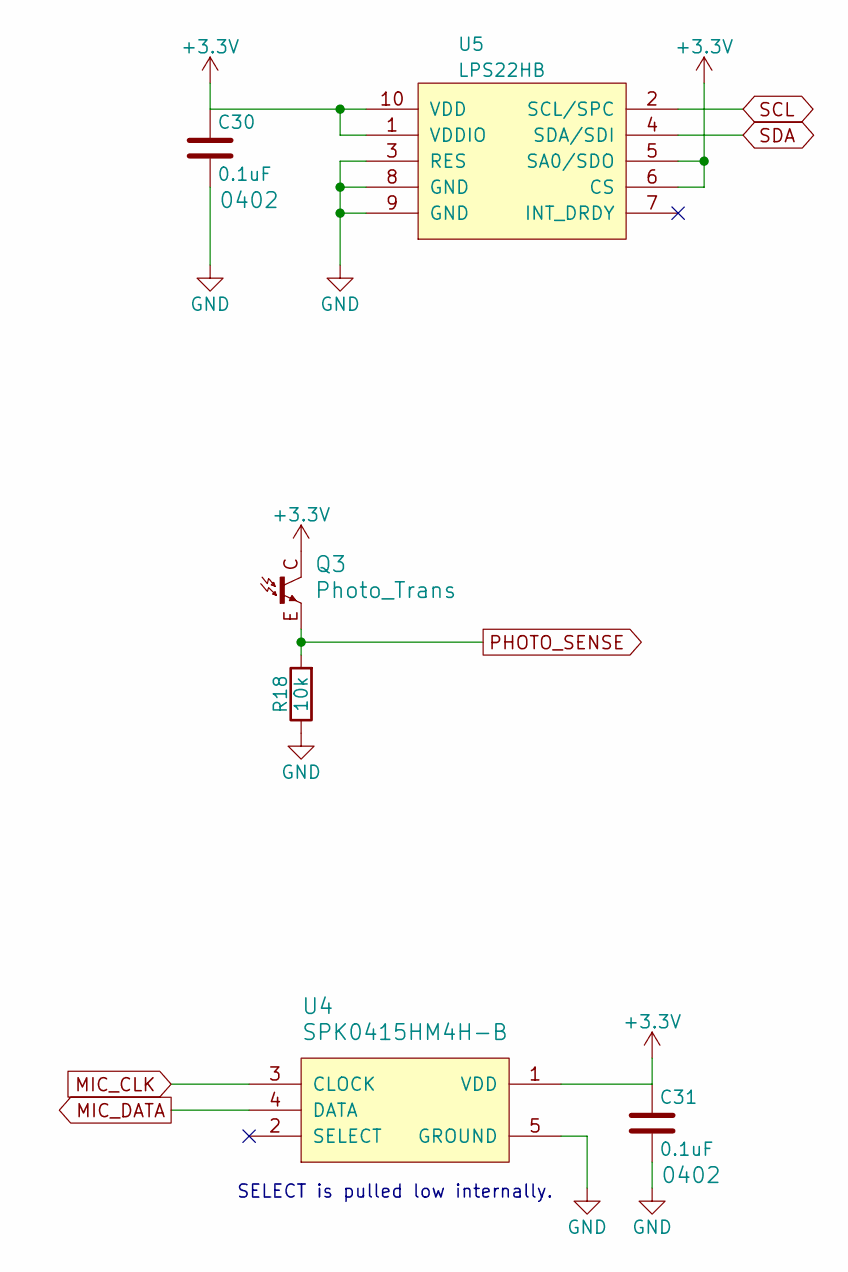
[picture p18: schematic Sensors.sch, Dronelight]

Parts:
C30, C31: 0.1uF; C_0402; Manufacturer Part Number MF-CAP-0402-0.1uF
Q3: Photo_Trans; Photo_Trans_ALS-PT19-315C; Manufacturer Part Number ALS-PT19-315C/L177/TR8
R18: 10k; R_0603; Manufacturer Part Number MF-RES-0603-10K
U4: SPK0415HM4H-B; SPK0415HM4H-8; Manufacturer Part Number SPK0415HM4H-B-7
U5: LPS22HB; LGA10R50P2X3_200X200X80; Manufacturer Part Number LPS22HBTR

Connections:
+3V3: C30.1, C31.1, Q3.C, U4.1 (VDD), U5.1 (VDDIO), U5.5 (SA0/SDO), U5.6 (CS), U5.10 (VDD); also elsewhere on the board
GND: C30.2, C31.2, R18.1, U4.5 (GROUND), U5.3 (RES), U5.8 (GND), U5.9 (GND); also elsewhere on the board
MIC_CLK: U4.3 (CLOCK); also elsewhere on the board
MIC_DATA: U4.4 (DATA); also elsewhere on the board
PHOTO_SENSE: Q3.E, R18.2; also elsewhere on the board
SCL: U5.2 (SCL/SPC); also elsewhere on the board
SDA: U5.4 (SDA/SDI); also elsewhere on the board

Notes on the sheet:
SELECT is pulled low internally.

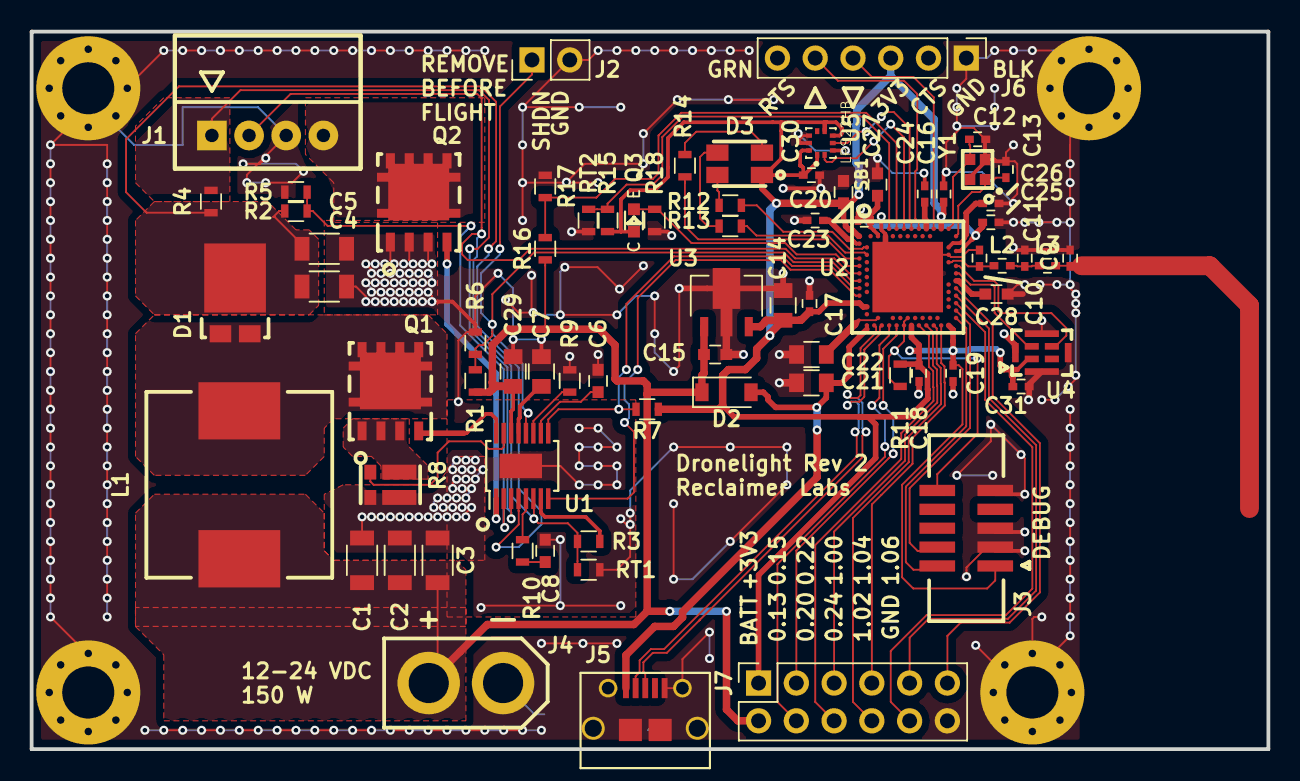
[picture p19: board dronelight.kicad_pcb from above]

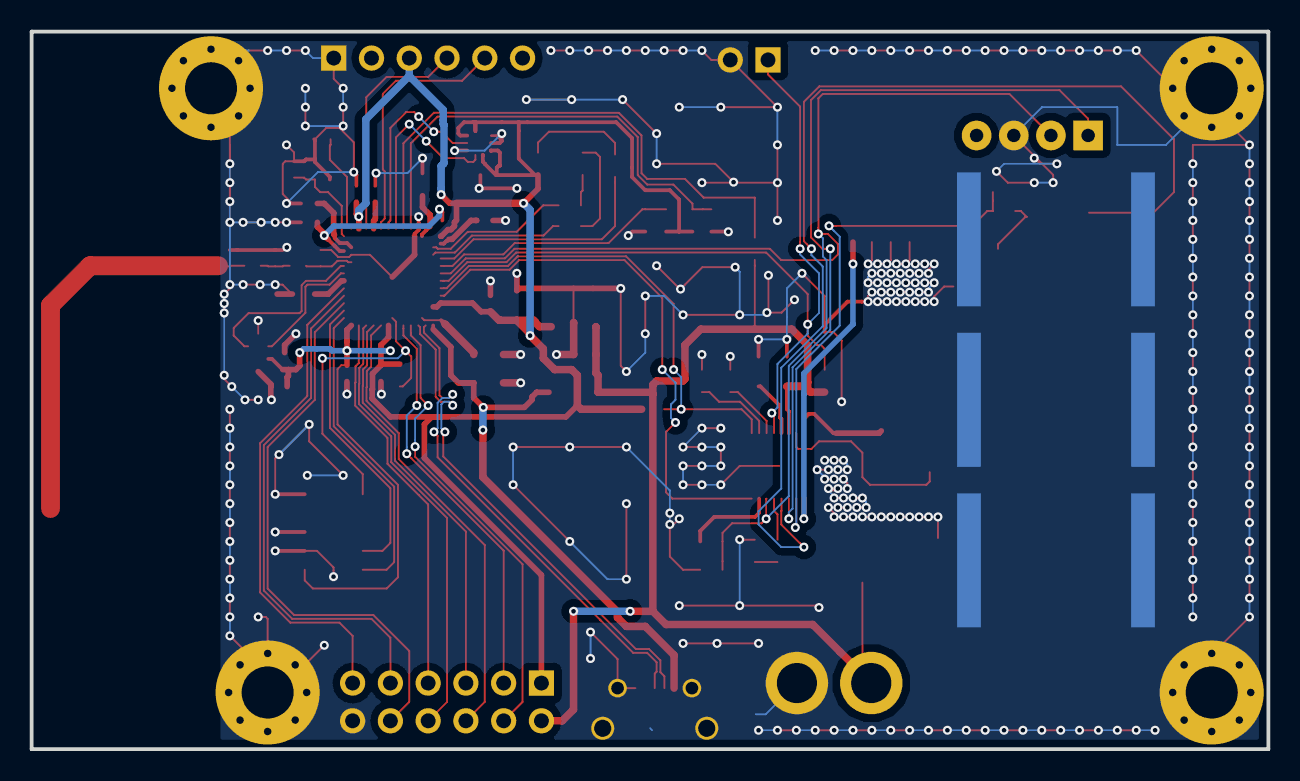
[picture p20: board dronelight.kicad_pcb from below]

Board: 2 copper layers, 83.2 x 48.3 mm, 81 parts (3 on the bottom side), 63 nets.
