ReclaimerLabs/Dronelight/(commit log)

2016-05-10 Initial Commit
    Initial commit of Rev 1 hardware and software
    [dronelight-B.Cu.gbl, dronelight-B.Mask.gbs, dronelight-B.SilkS.gbo, dronelight-Dwgs.User.gbr, dronelight-Edge.Cuts.gm1, dronelight-F.Cu.gtl, dronelight-F.Mask.gts, dronelight-F.Paste.gtp]
2017-11-29 Rev 1 redone
    [Connectors_Misc.sch, LED_Driver_Boost.sch, Sensors.sch, _saved_nrf52840.sch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]
